Ryzee119/n360/(threads)

Thread 2 (2020-01-29):

Computer control

networkfusion, 2020-01-29:
A strange issue, I must admit, but I would like to be able to send controller commands from a PC (probably Raspberry PI) to an N64 in order to emulate controller input. This will allow me to remotely test homebrew programs without being in front of the N64. Given your work on this product (and the fact that I have one installed) is there any examples you can give?

networkfusion, 2020-11-27:
Given that this project is superseeded, any chance of adding instructions that add the other (closed source) bits to this for people that have this version...
