Ryzee119/n360/n360_schematic Rev0.pdf

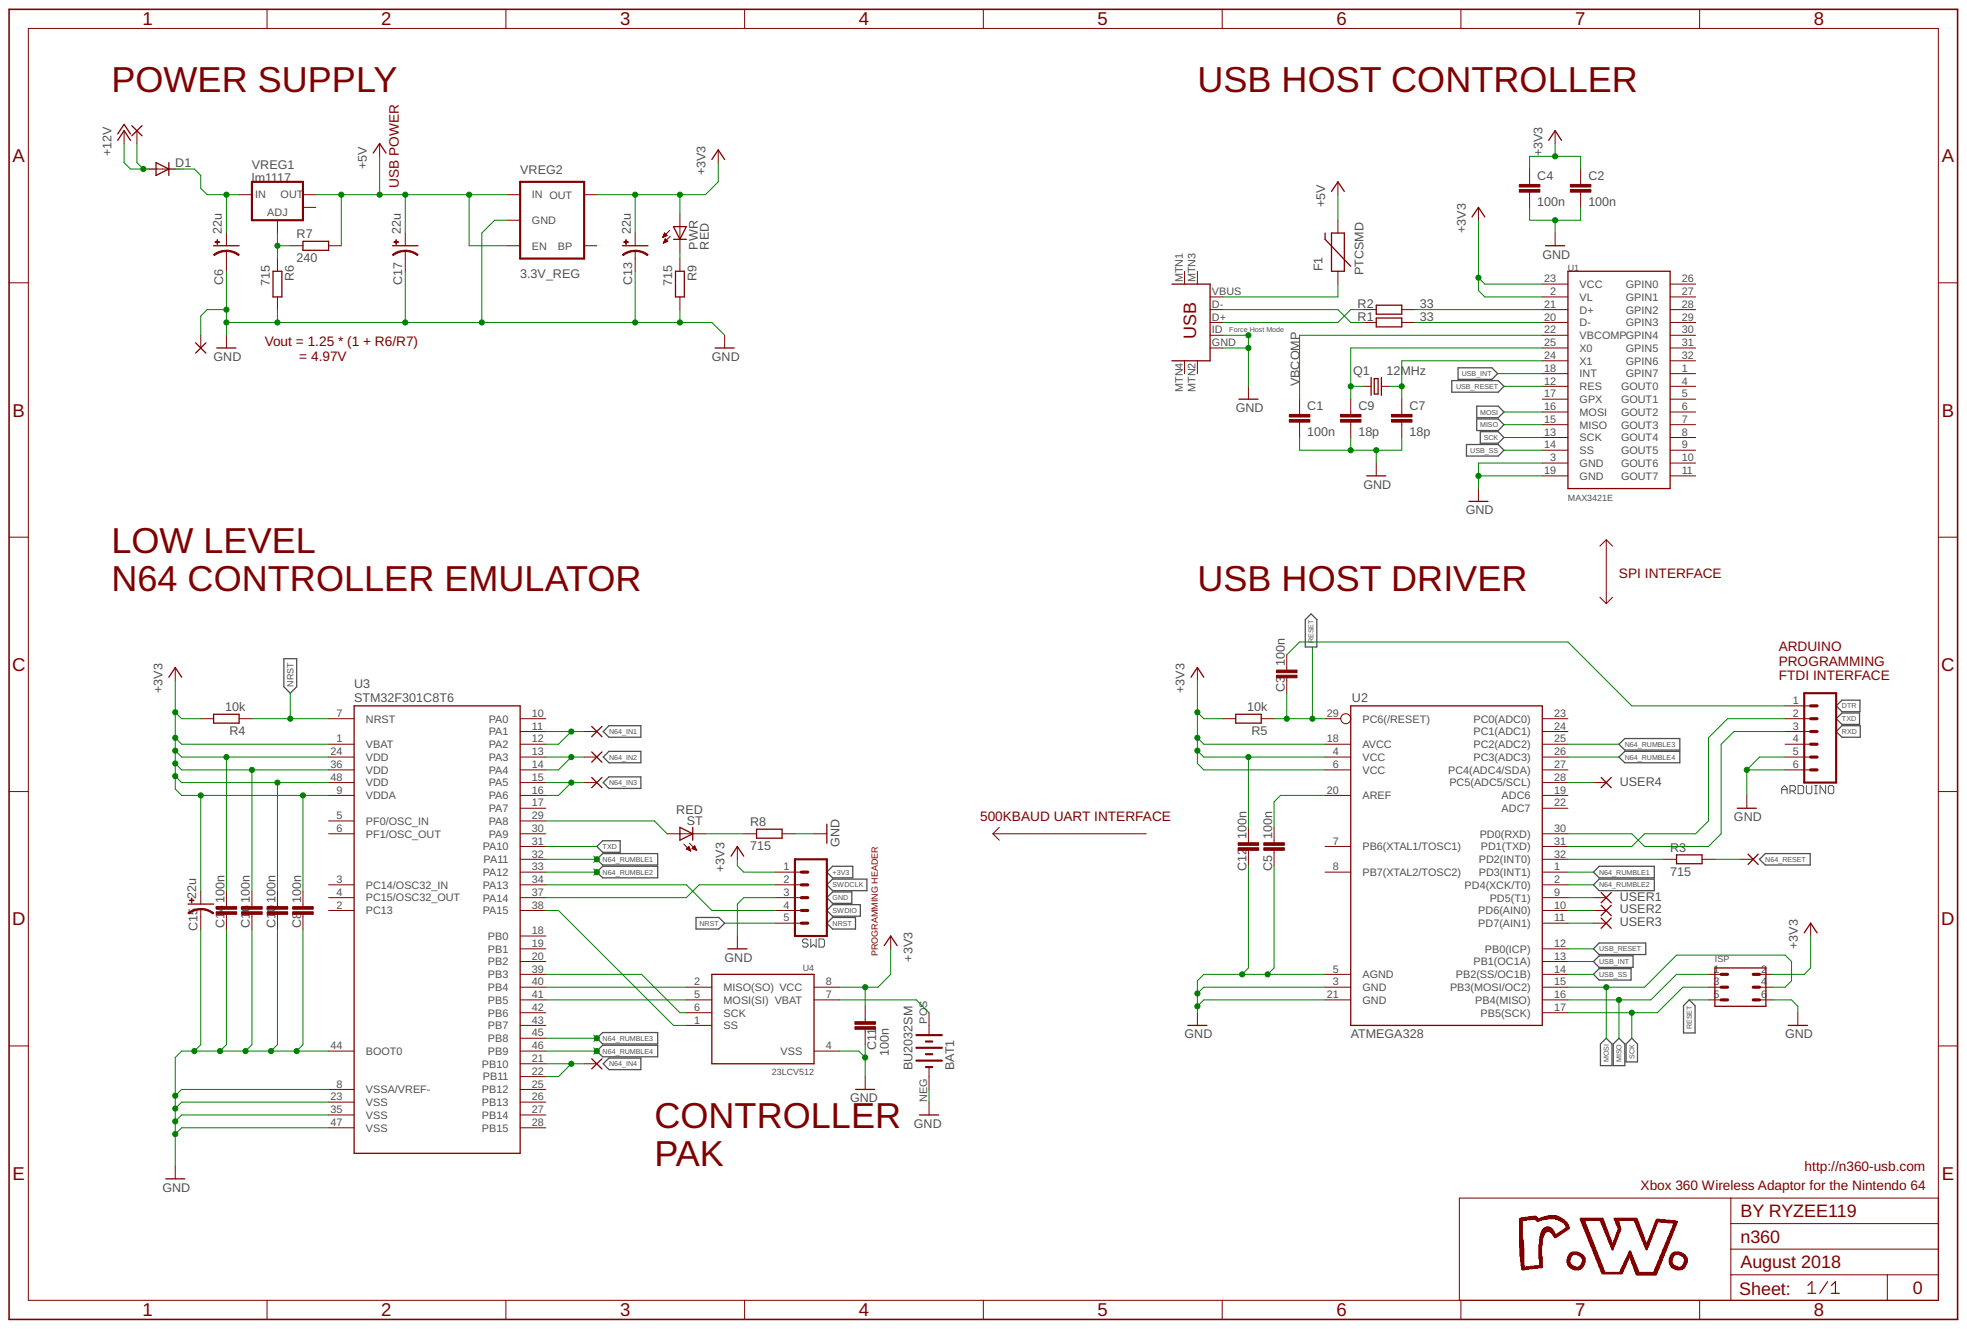
[picture p10: page 1]

48

Xbox 360 Wireless Adaptor for the Nintendo 64
