Ryzee119/n360/(commit log)

2018-09-09 Wired Xbone Controllers
2018-09-11 As built schematic Rev 0
2019-04-26 Added 8bitdo wireless adaptor support
